jobitjoseph/GL868_ESP32/Hardware/GL868_ESP32V3.1/GL868_ESP32V3.1.pdf

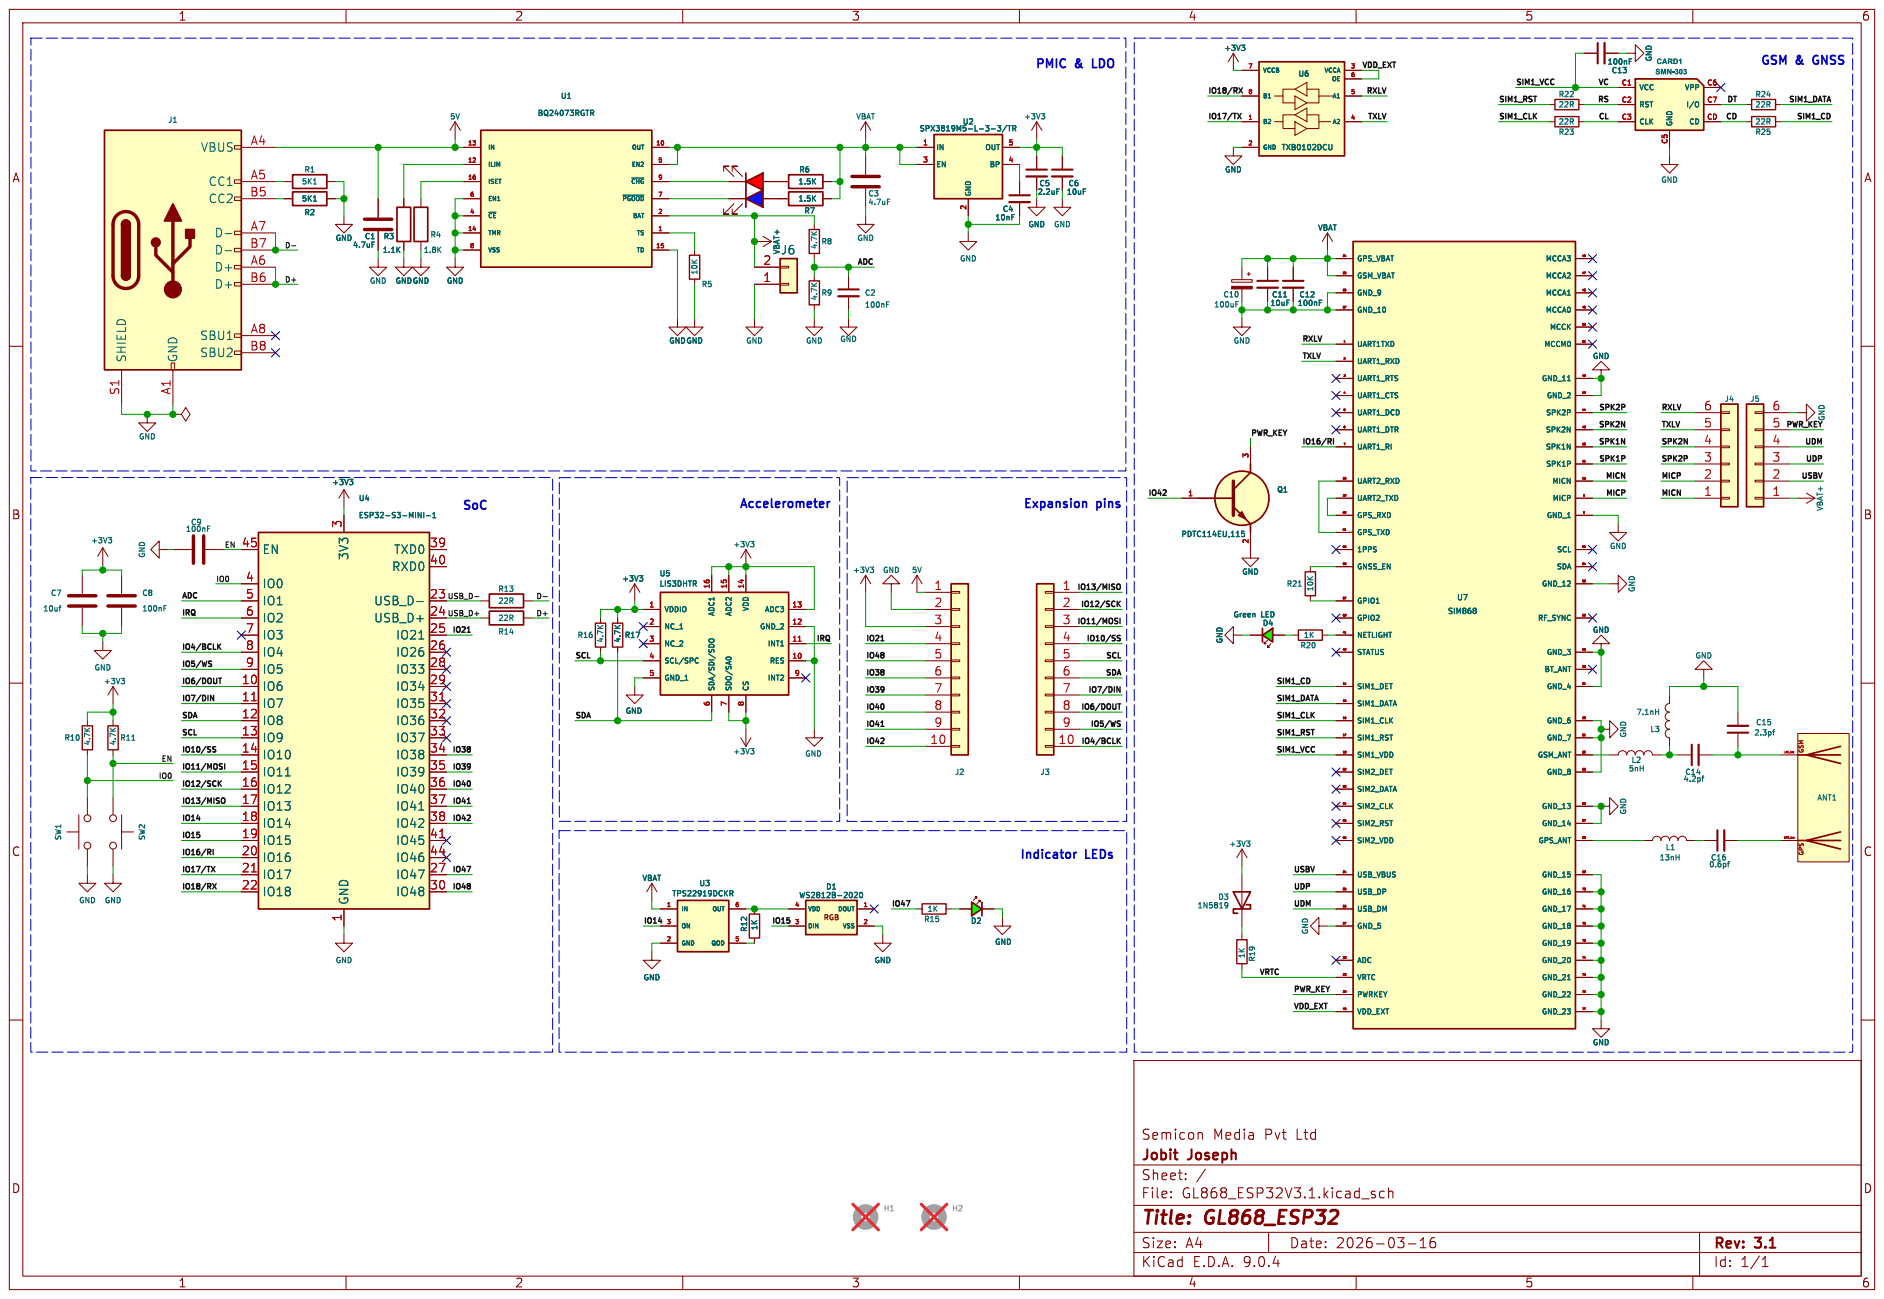
[picture p1: page 1]
