jobitjoseph/GL868_ESP32/Hardware/GL868_ESP32V3.1/GL868_ESP32V3.1.kicad_pcb

## KiCad design Hardware/GL868_ESP32V3.1/GL868_ESP32V3.1.kicad_pcb (2026-03-16)

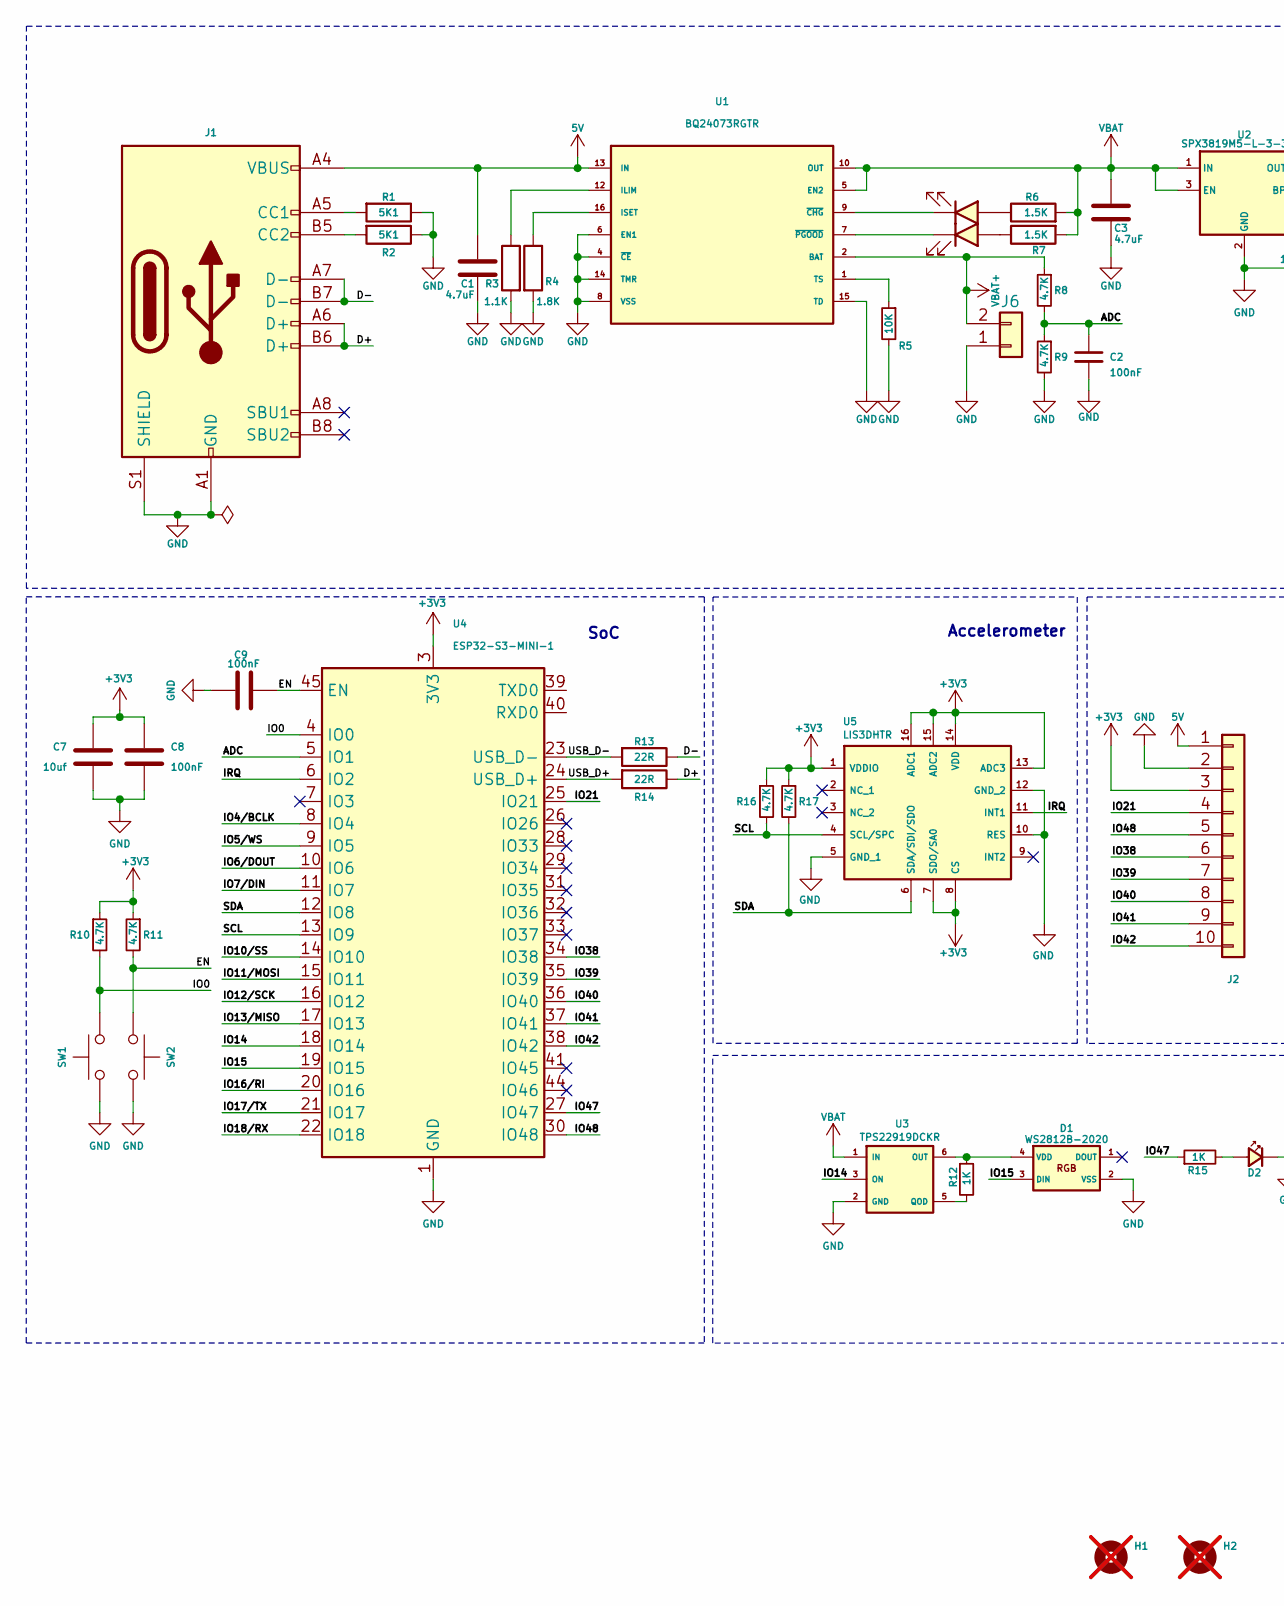
[picture p2: schematic GL868_ESP32V3.1.kicad_sch, GL868_ESP32, part in row 1, column 1]

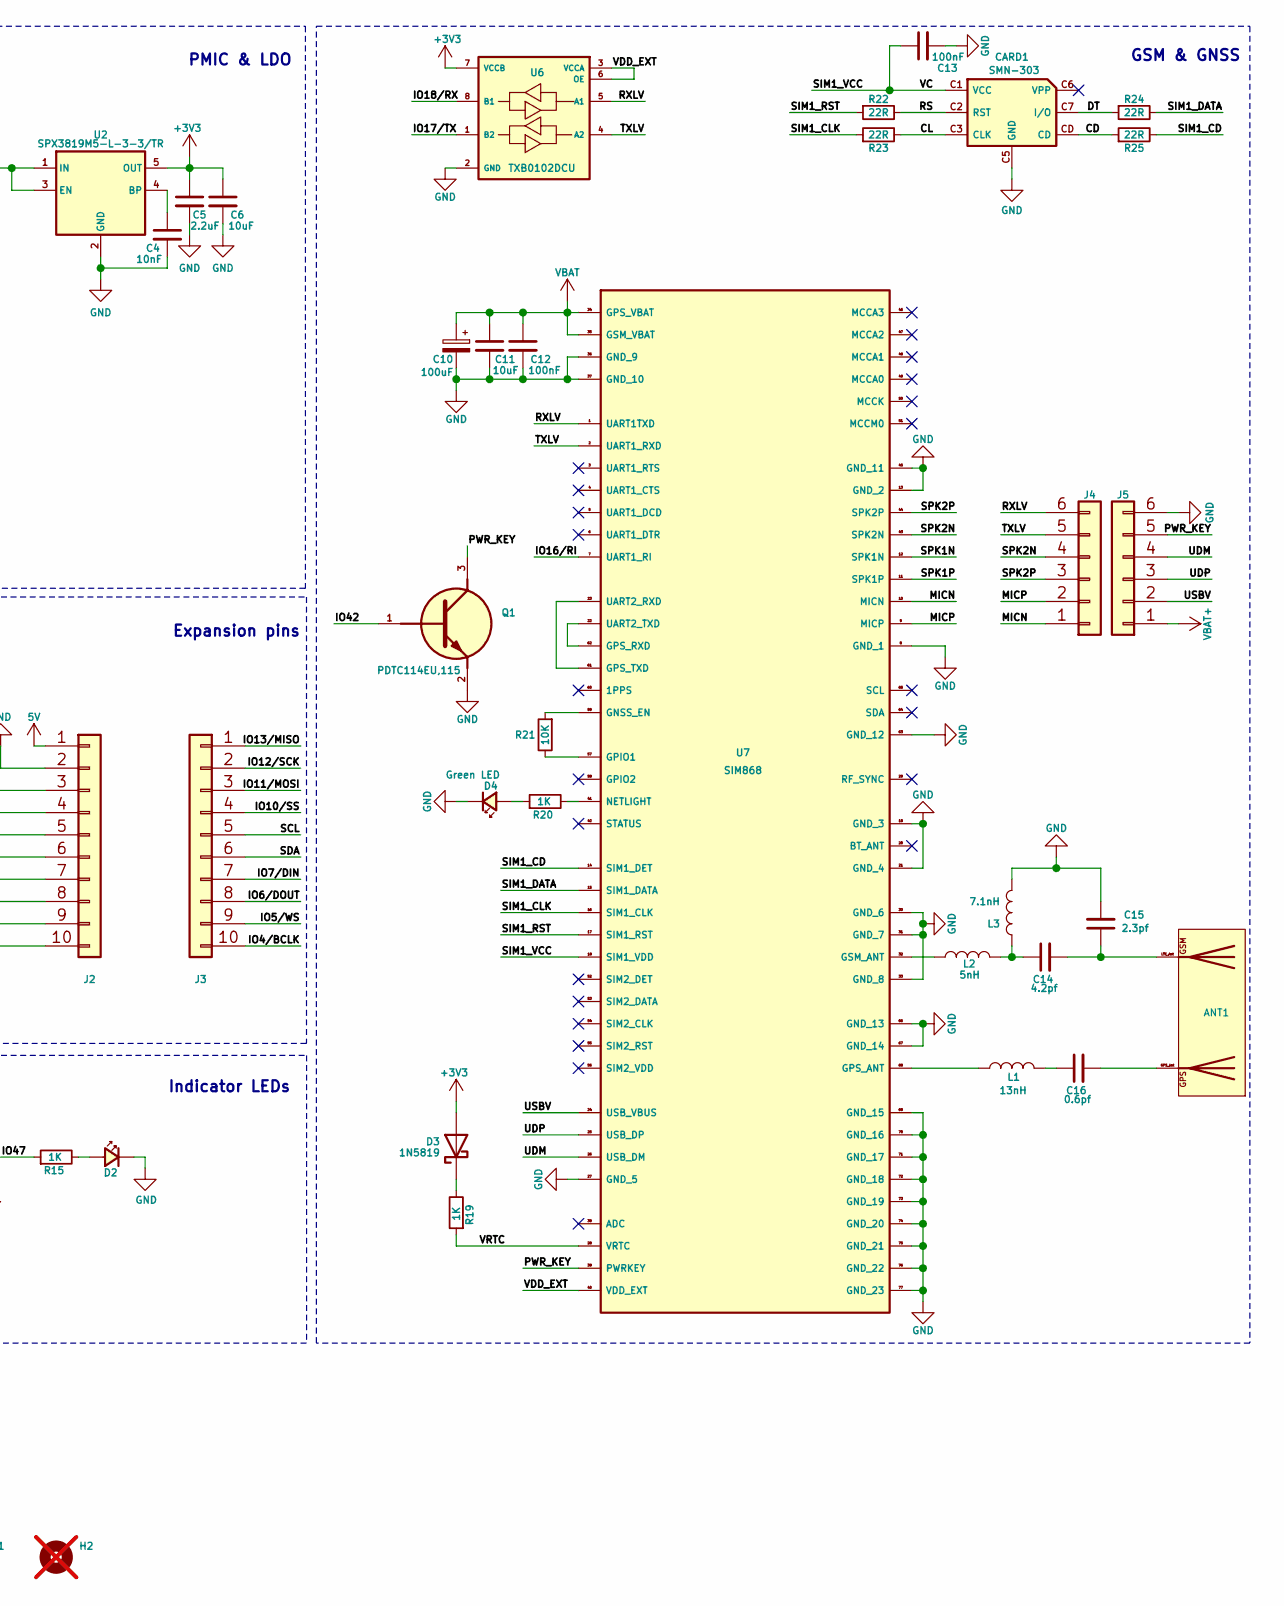
[picture p3: schematic GL868_ESP32V3.1.kicad_sch, GL868_ESP32, part in row 1, column 2]

Parts:
ANT1: ANT; GL868_Combo_ANT
C1, C3: 4.7uF; C_0402_1005Metric; LCSC Part # C23733
C2, C8, C9, C12, C13: 100nF; C_0402_1005Metric; LCSC Part # C307331
C4: 10nF; C_0402_1005Metric; LCSC Part # C15195
C5: 2.2uF; C_0402_1005Metric; LCSC Part # C12530
C6, C11: 10uF; C_0402_1005Metric; LCSC Part # C15525
C7: 10uf; C_0402_1005Metric; LCSC Part # C15525
C10: 100uF; CP_EIA-3528-15_AVX-H; LCSC Part # C16133
C14: 4.2pf; C_0402_1005Metric; LCSC Part # C1855356
C15: 2.3pf; C_0402_1005Metric; LCSC Part # C2190124
C16: 0.6pf; C_0402_1005Metric; LCSC Part # C426333
CARD1: SMN-303; SIM-SMD_SMN-303; Manufacturer Part SMN-303; LCSC Part # C266888
D1: WS2812B-2020; LED_WS2812B-2020_PLCC4_2.0x2.0mm; LCSC Part # C5349955
D2, D4: Green LED; LED_0603_1608Metric; LCSC Part # C965804
D3: 1N5819; D_SOD-523; LCSC Part # C5185918
H1, H2: MountingHole; MountingHole_2.2mm_M2_DIN965; not fitted
J1: USB_C_Receptacle_USB2.0; USB_C_Receptacle_HRO_TYPE-C-31-M-12; LCSC Part # C2765186
J2, J3: Conn_01x10; PinHeader_1x10_P2.54mm_Vertical
J4, J5: Conn_01x06; PinHeader_1x06_P2.54mm_Vertical
J6: Conn_01x02; CONN-SMD_2P-P2.50_HCTL_HC-XH-2ALT; LCSC Part # C7429680
L1: 13nH; L_0402_1005Metric; LCSC Part # C2991840
L2: 5nH; L_0402_1005Metric
L3: 7.1nH; L_0402_1005Metric
LED1: Red LED; LED_0603_1608Metric; LCSC Part # C2286
LED2: Blue LED; LED_0603_1608Metric; LCSC Part # C965807
Q1: PDTC114EU,115; PDTC114EU115; LCSC Part # C135830
R1, R2: 5K1; R_0402_1005Metric; LCSC Part # C25905
R3: 1.1K; R_0402_1005Metric; LCSC Part # C174195
R4: 1.8K; R_0402_1005Metric; LCSC Part # C25867
R5, R21: 10K; R_0402_1005Metric; LCSC Part # C25744
R6, R7: 1.5K; R_0402_1005Metric; LCSC Part # C25867
R8, R9, R10, R11, R16, R17: 4.7K; R_0402_1005Metric; LCSC Part # C25900
R12, R15, R19, R20: 1K; R_0402_1005Metric; LCSC Part # C11702
R13, R14, R22, R23, R24, R25: 22R; R_0402_1005Metric; LCSC Part # C25092
SW1, SW2: SW_Push; Tactile 3x4x2mm TS-A010; LCSC Part # C720477
U1: BQ24073RGTR; IC_BQ24072RGTR; LCSC Part # C15220
U2: SPX3819M5-L-3-3/TR; SOT-23-5; LCSC Part # C9055
U3: TPS22919DCKR; SOT65P210X110-6N; LCSC Part # C2149796
U4: ESP32-S3-MINI-1; ESP32-S2-MINI-1; LCSC Part # C3013941
U5: LIS3DHTR; LCSC Part # C15134
U6: TXB0102DCU; VSSOP-8_2.3x2mm_P0.5mm; LCSC Part # C60709
U7: SIM868; LCSC Part # C39162023

Connections:
5V: C1.1, J1.A4 (VBUS), J1.A9 (VBUS), J1.B4 (VBUS), J1.B9 (VBUS), J2.1, U1.13 (IN)
+3V3: C5.1, C6.1, C7.1, C8.1, D3.2 (A), J2.3, R10.1, R11.1, R16.1, R17.1, U2.5 (OUT), U4.3 (3V3), U5.1 (VDDIO), U5.7 (SDO/SA0), U5.8 (CS), U5.13 (ADC3), U5.14 (VDD), U5.15 (ADC2), U5.16 (ADC1), U6.7 (VCCB)
/ADC: C2.1, R8.2, R9.1, U4.5 (IO1)
/CD: CARD1.CD, R25.1
/CL: CARD1.C3 (CLK), R23.2
/D+: J1.A6 (D+), J1.B6 (D+), R14.1
/D-: J1.A7 (D-), J1.B7 (D-), R13.1
/DT: CARD1.C7 (I/O), R24.1
/EN: C9.1, R11.2, SW2.1, U4.45 (EN)
/IO0: R10.2, SW1.2, U4.4 (IO0)
/IO4/BCLK: J3.10, U4.8 (IO4)
/IO5/WS: J3.9, U4.9 (IO5)
/IO6/DOUT: J3.8, U4.10 (IO6)
/IO7/DIN: J3.7, U4.11 (IO7)
/IO10/SS: J3.4, U4.14 (IO10)
/IO11/MOSI: J3.3, U4.15 (IO11)
/IO12/SCK: J3.2, U4.16 (IO12)
/IO13/MISO: J3.1, U4.17 (IO13)
/IO14: U3.3 (ON), U4.18 (IO14)
/IO15: D1.3 (DIN), U4.19 (IO15)
/IO16/RI: U4.20 (IO16), U7.7 (UART1_RI)
/IO17/TX: U4.21 (IO17), U6.1 (B2)
/IO18/RX: U4.22 (IO18), U6.8 (B1)
/IO21: J2.4, U4.25 (IO21)
/IO38: J2.6, U4.34 (IO38)
/IO39: J2.7, U4.35 (IO39)
/IO40: J2.8, U4.36 (IO40)
/IO41: J2.9, U4.37 (IO41)
/IO42: J2.10, Q1.1 (B), U4.38 (IO42)
/IO47: R15.1, U4.27 (IO47)
/IO48: J2.5, U4.30 (IO48)
/IRQ: U4.6 (IO2), U5.11 (INT1)
/MICN: J4.1, U7.10 (MICN)
/MICP: J4.2, U7.9 (MICP)
/PWR_KEY: J5.5, Q1.3 (C), U7.39 (PWRKEY)
/RS: CARD1.C2 (RST), R22.2
/RXLV: J4.6, U6.5 (A1), U7.1 (UART1TXD)
/SCL: J3.5, R16.2, U4.13 (IO9), U5.4 (SCL/SPC)
/SDA: J3.6, R17.2, U4.12 (IO8), U5.6 (SDA/SDI/SDO)
/SIM1_CD: R25.2, U7.14 (SIM1_DET)
/SIM1_CLK: R23.1, U7.16 (SIM1_CLK)
/SIM1_DATA: R24.2, U7.15 (SIM1_DATA)
/SIM1_RST: R22.1, U7.17 (SIM1_RST)
/SIM1_VCC: C13.1, CARD1.C1 (VCC), U7.18 (SIM1_VDD)
/SPK1N: U7.12 (SPK1N)
/SPK1P: U7.11 (SPK1P)
/SPK2N: J4.4, U7.43 (SPK2N)
/SPK2P: J4.3, U7.44 (SPK2P)
/TXLV: J4.5, U6.4 (A2), U7.2 (UART1_RXD)
/UDM: J5.4, U7.26 (USB_DM)
/UDP: J5.3, U7.25 (USB_DP)
/USBV: J5.2, U7.24 (USB_VBUS)
/USB_D+: R14.2, U4.24 (USB_D+)
/USB_D-: R13.2, U4.23 (USB_D-)
/VDD_EXT: U6.3 (VCCA), U6.6 (OE), U7.40 (VDD_EXT)
/VRTC: R19.1, U7.28 (VRTC)
GND: C1.2, C2.2, C3.2, C4.2, C5.2, C6.2, C7.2, C8.2, C9.2, C10.2, C11.2, C12.2, C13.2, C15.2, CARD1.8 (EP), CARD1.9 (EP), CARD1.10 (EP), CARD1.11 (EP), CARD1.C5 (GND), D1.2 (VSS), D2.1 (K), D4.1 (K), J1.A1 (GND), J1.A12 (GND), J1.B1 (GND), J1.B12 (GND), J1.S1 (SHIELD), J2.2, J5.6, J6.1, L3.2, Q1.2 (E), R1.1, R2.1, R3.2, R4.2, R5.2, R9.2, SW1.1, SW2.2, U1.4 (~CE), U1.6 (EN1), U1.8 (VSS), U1.14 (TMR), U1.15 (TD), U1.17 (EXP), U2.2 (GND), U3.2 (GND), U4.1 (GND), U4.2 (GND), U4.42 (GND), U4.43 (GND), U4.46 (GND), U4.47 (GND), U4.48 (GND), U4.49 (GND), U4.50 (GND), U4.51 (GND), U4.52 (GND), U4.53 (GND), U4.54 (GND), U4.55 (GND), U4.56 (GND), U4.57 (GND), U4.58 (GND), U4.59 (GND), U4.60 (GND), U4.61 (GND), U4.62 (GND), U4.63 (GND), U4.64 (GND), U4.65 (GND), U5.5 (GND_1), U5.10 (RES), U5.12 (GND_2), U6.2 (GND), U7.8 (GND_1), U7.13 (GND_2), U7.19 (GND_3), U7.21 (GND_4), U7.27 (GND_5), U7.30 (GND_6), U7.31 (GND_7), U7.33 (GND_8), U7.36 (GND_9), U7.37 (GND_10), U7.45 (GND_11), U7.63 (GND_12), U7.66 (GND_13), U7.67 (GND_14), U7.69 (GND_15), U7.70 (GND_16), U7.71 (GND_17), U7.72 (GND_18), U7.73 (GND_19), U7.74 (GND_20), U7.75 (GND_21), U7.76 (GND_22), U7.77 (GND_23)
unnamed: ANT1.GPS_Ant, C16.2
unnamed: ANT1.LTE_Ant, C14.2, C15.1
unnamed: C14.1, L2.2, L3.1
unnamed: C16.1, L1.2
unnamed: D1.4 (VDD), R12.1, U3.6 (OUT)
unnamed: D2.2 (A), R15.2
unnamed: D3.1 (K), R19.2
unnamed: D4.2 (A), R20.1
unnamed: J1.A5 (CC1), R1.2
unnamed: J1.B5 (CC2), R2.2
unnamed: LED1.2 (A), R6.1
unnamed: LED1.1 (K), U1.9 (~CHG)
unnamed: LED2.2 (A), R7.1
unnamed: LED2.1 (K), U1.7 (~PGOOD)
unnamed: R3.1, U1.12 (ILIM)
unnamed: R4.1, U1.16 (ISET)
unnamed: R5.1, U1.1 (TS)
unnamed: C4.1, U2.4 (BP)
unnamed: R12.2, U3.5 (QOD)
unnamed: R21.1, U7.59 (GNSS_EN)
unnamed: R21.2, U7.57 (GPIO1)
unnamed: L1.1, U7.68 (GPS_ANT)
unnamed: U7.22 (UART2_TXD), U7.62 (GPS_RXD)
unnamed: U7.23 (UART2_RXD), U7.61 (GPS_TXD)
unnamed: L2.1, U7.32 (GSM_ANT)
unnamed: R20.2, U7.41 (NETLIGHT)
VBAT: C3.1, C10.1, C11.1, C12.1, R6.2, R7.2, U1.5 (EN2), U1.10 (OUT), U1.11 (OUT), U2.1 (IN), U2.3 (EN), U3.1 (IN), U7.34 (GPS_VBAT), U7.35 (GSM_VBAT)
VBAT+: J5.1, J6.2, R8.1, U1.2 (BAT), U1.3 (BAT)

Notes on the sheet:
PMIC & LDO
Indicator LEDs
Accelerometer
Expansion pins
SoC
GSM & GNSS

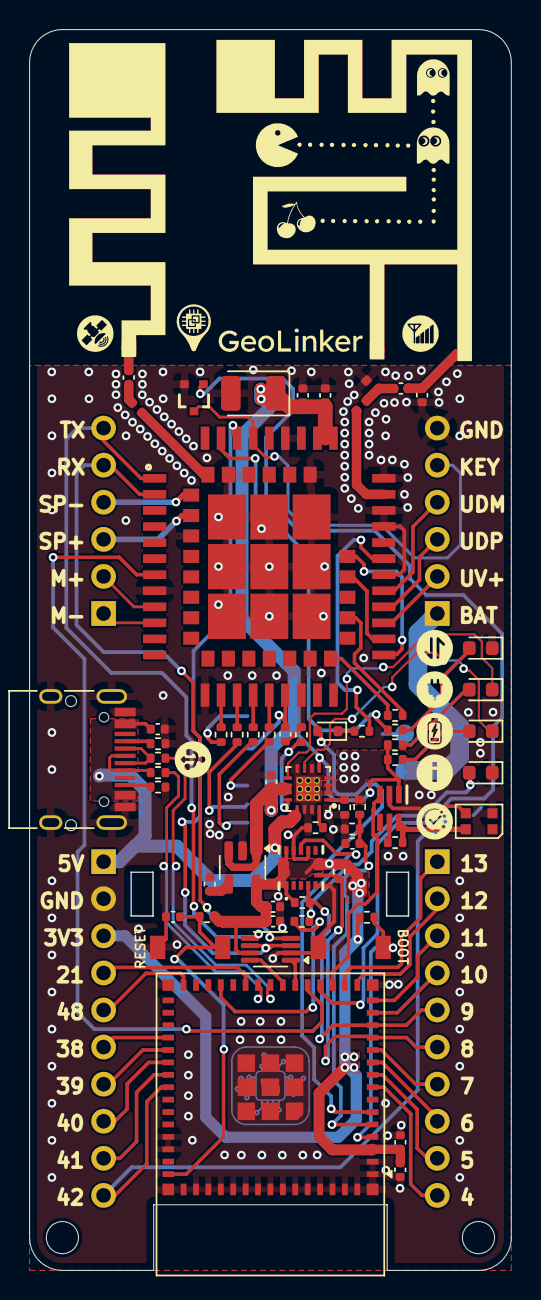
[picture p4: board GL868_ESP32V3.1.kicad_pcb from above]

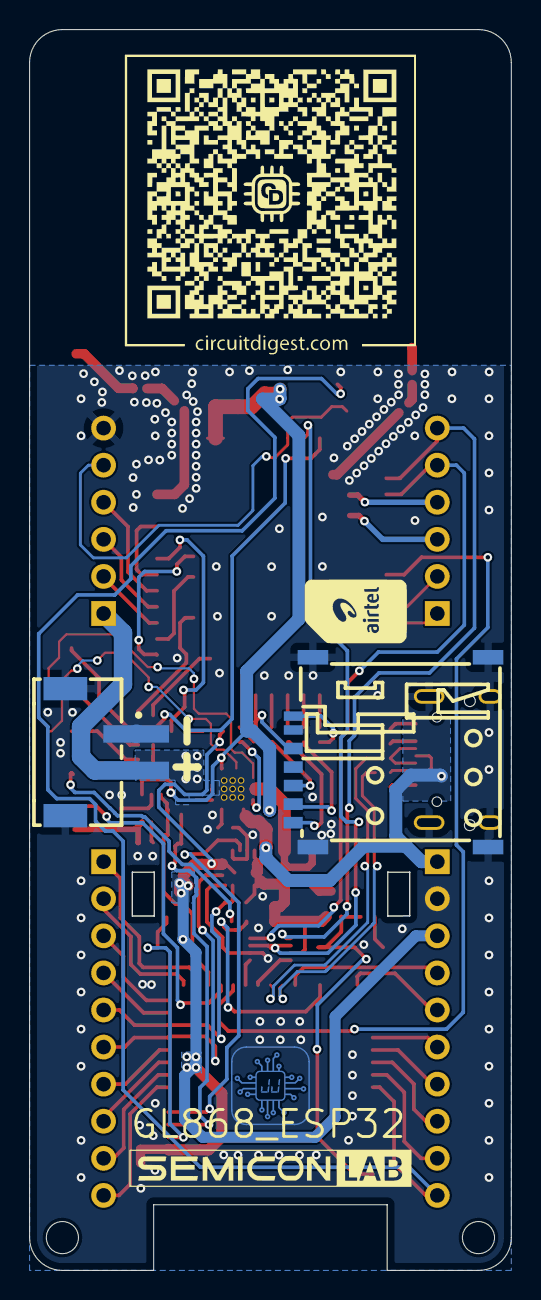
[picture p5: board GL868_ESP32V3.1.kicad_pcb from below]

Board: 2 copper layers, 33.0 x 85.0 mm, 69 parts (6 on the bottom side), 83 nets.
